rasmusravnandersen/EF_v1p0/Low Pass Eccosorb Filter.pptx

## Low Pass Eccosorb Filter

## Geometries

- Ideal stripline model

- Connectorised stripline on FR4-PCB

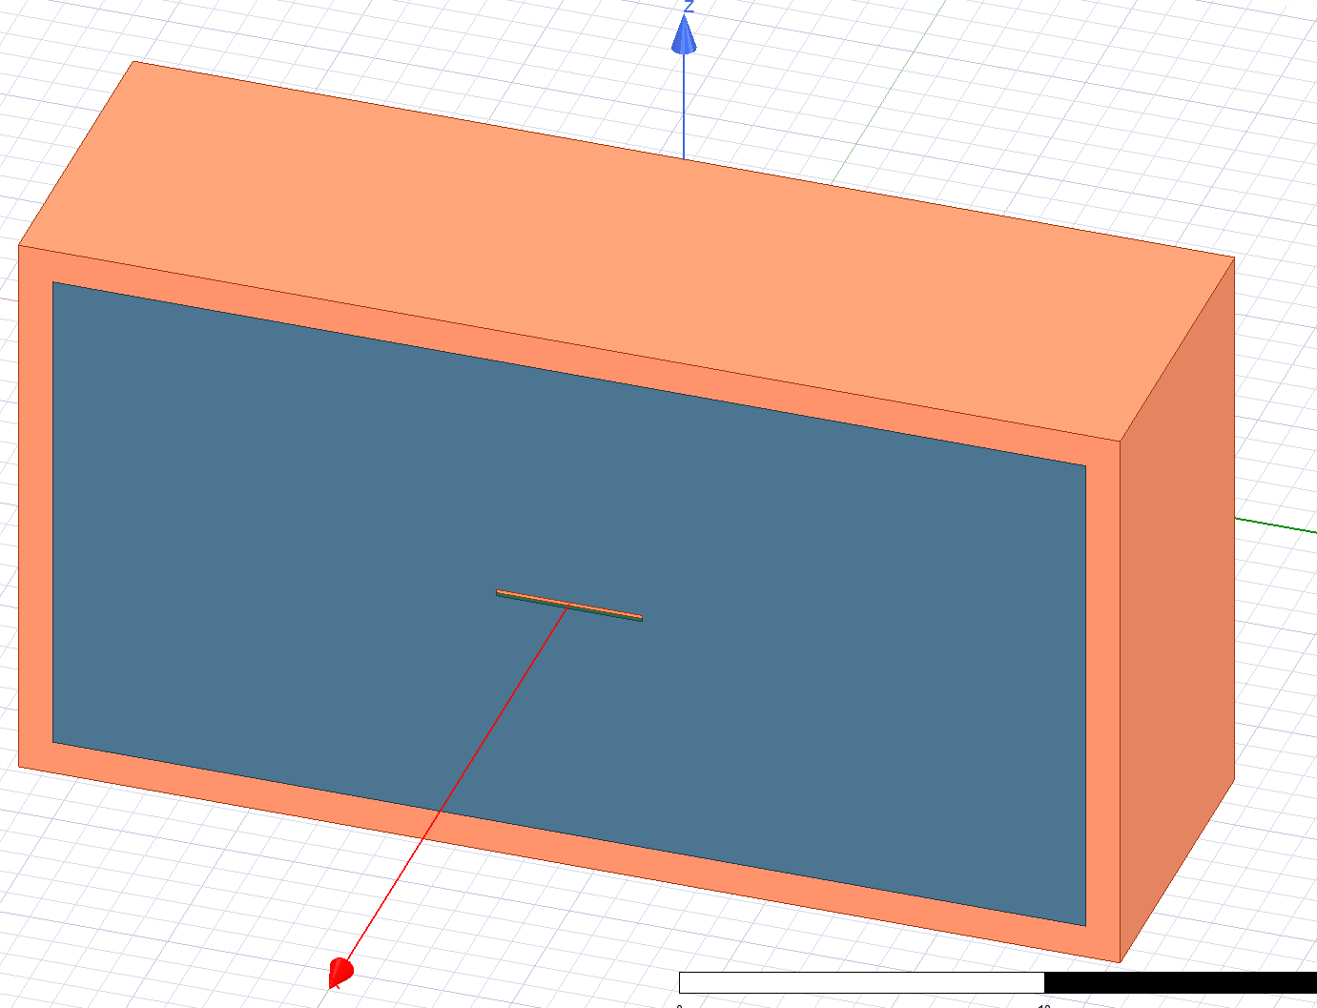
[picture p1: figure]
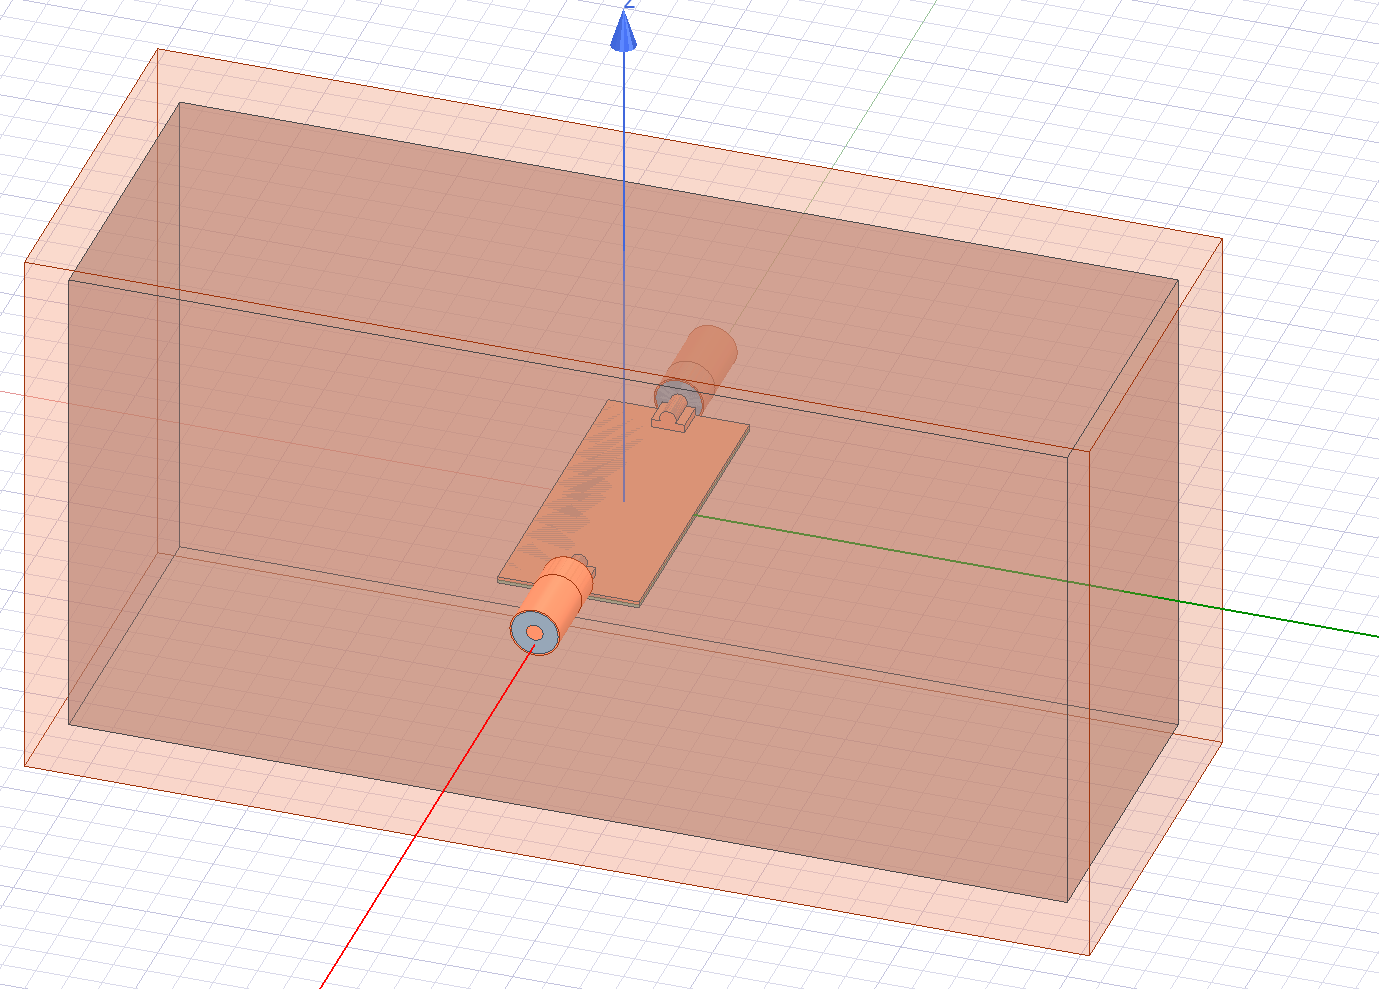
[picture p2: figure]

## Ideal Stripline 2D

- 2D simulations

- Trace width = 4.25 mm Box height = 15 mm, Box width = 30 mm

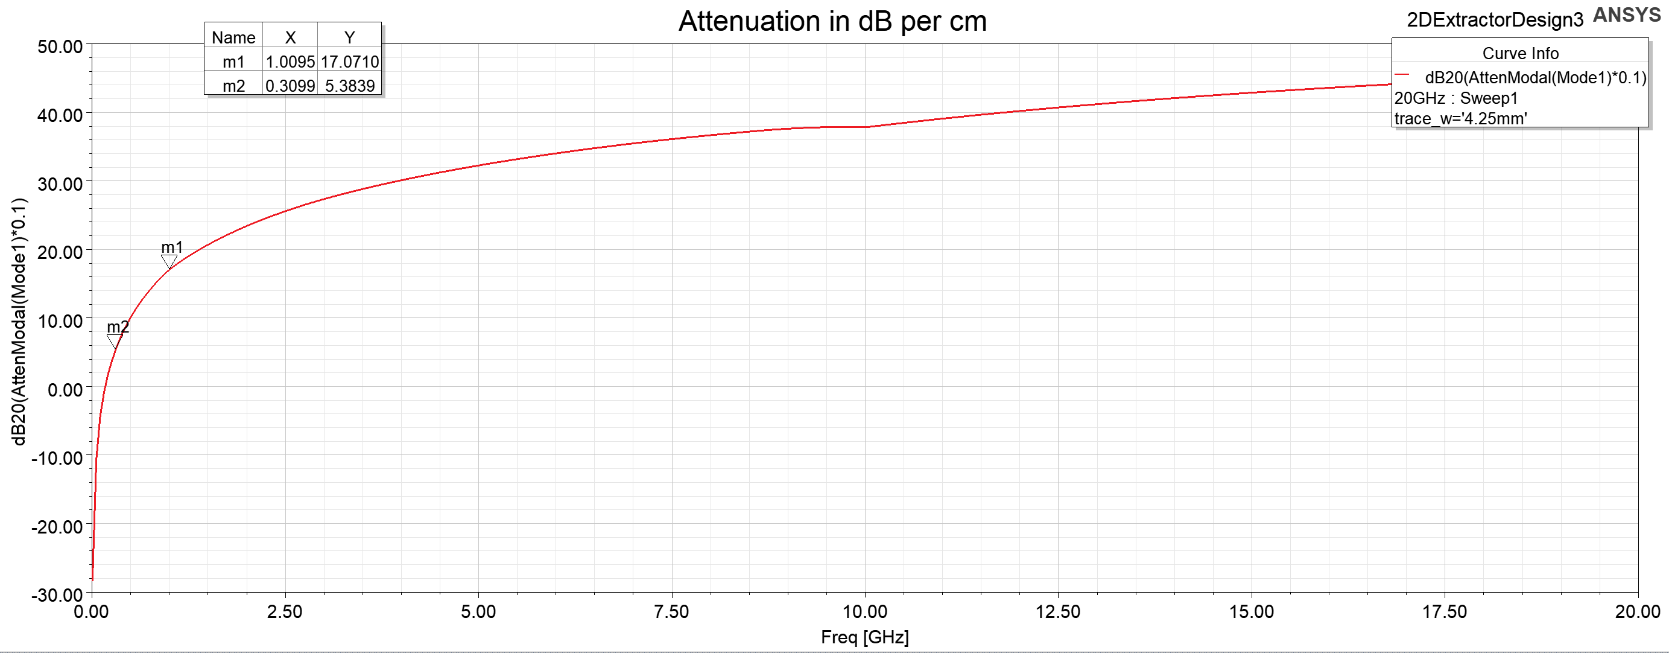
[picture p3: figure]
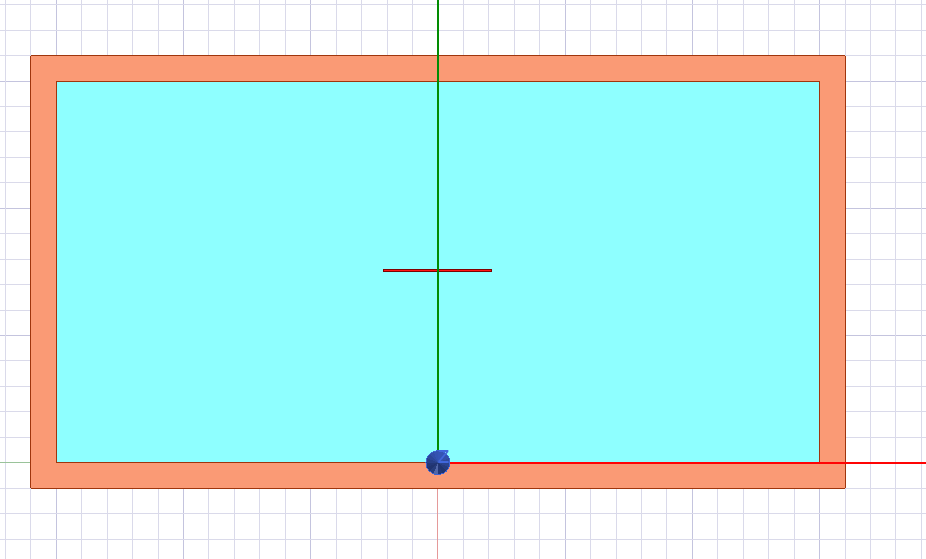
[picture p4: figure]
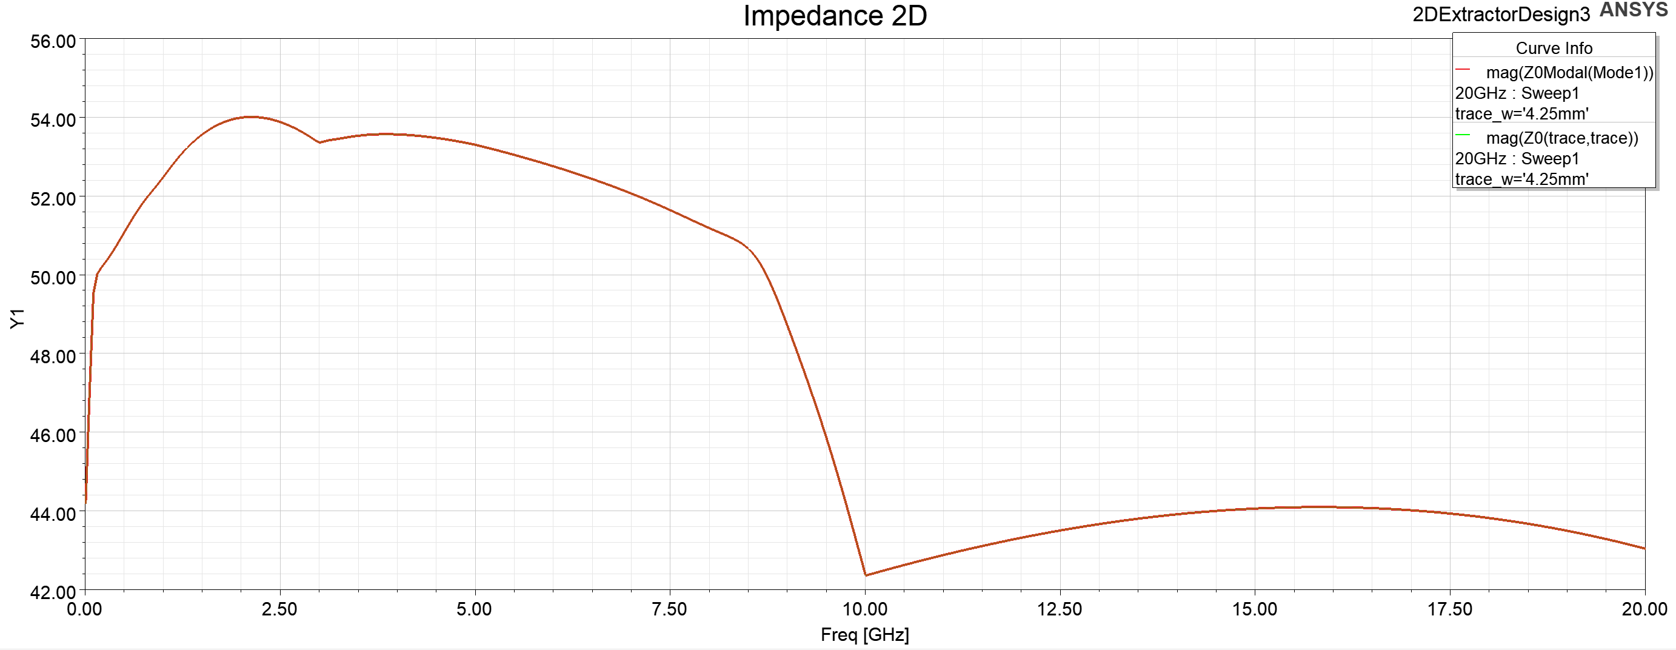
[picture p5: figure]

## Ideal Stripline 3D

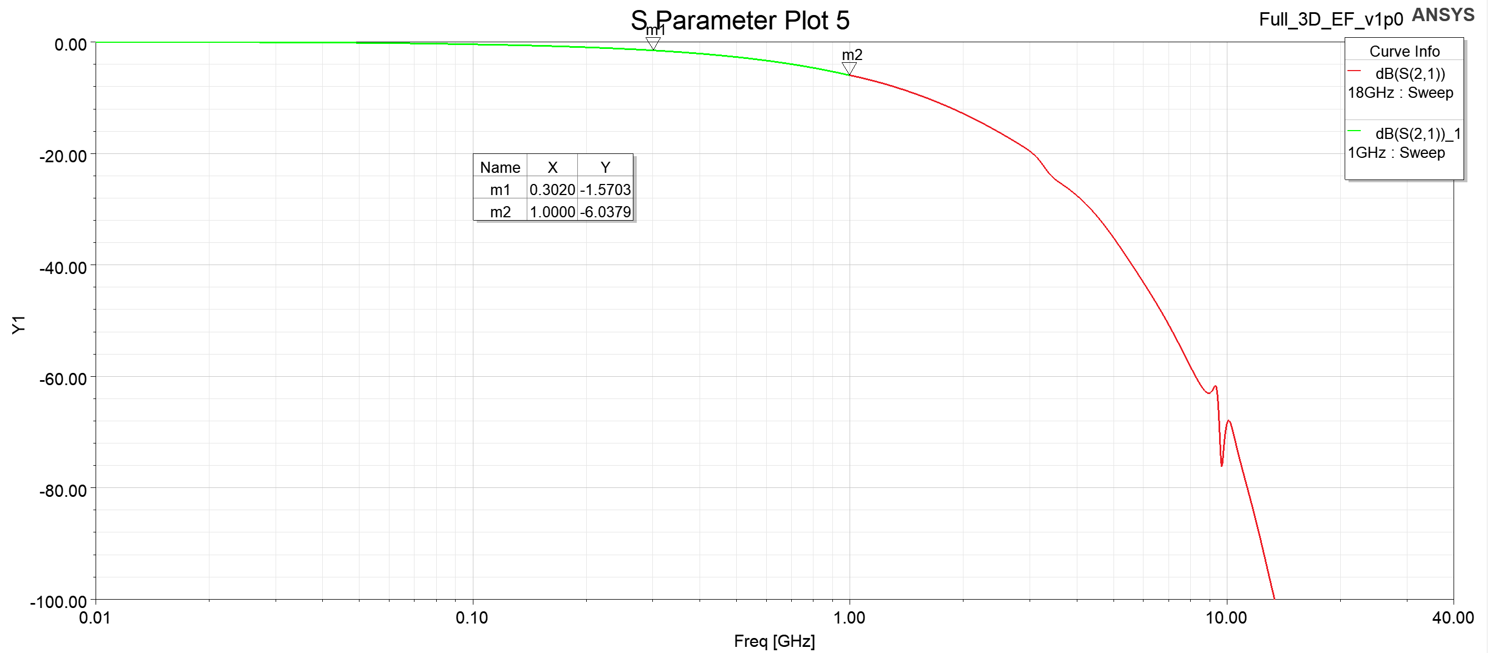
[picture p6: figure]

## Paper comparison

- Impedance-matched low-pass stripline filters by D. F. Santavicca and D. E. Prober

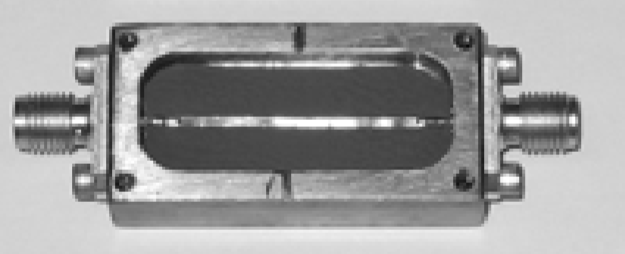
[picture p7: figure]

- Trace width = 1.4 mm Box height = 4.6 mm, Box width = 18 mm

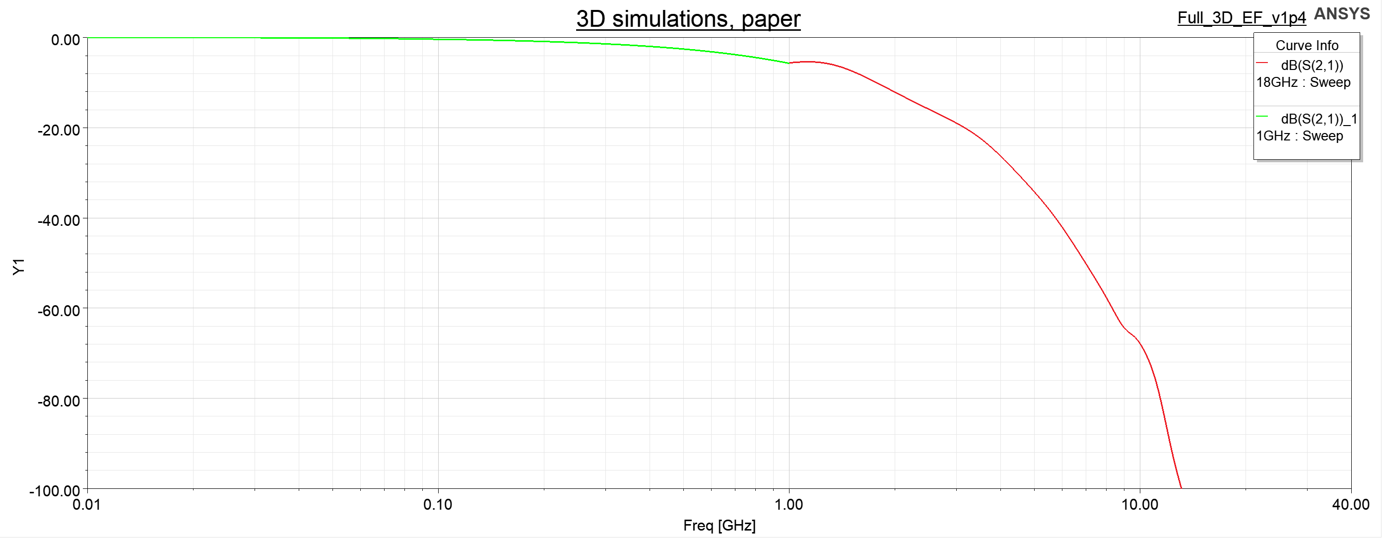
[picture p8: figure]
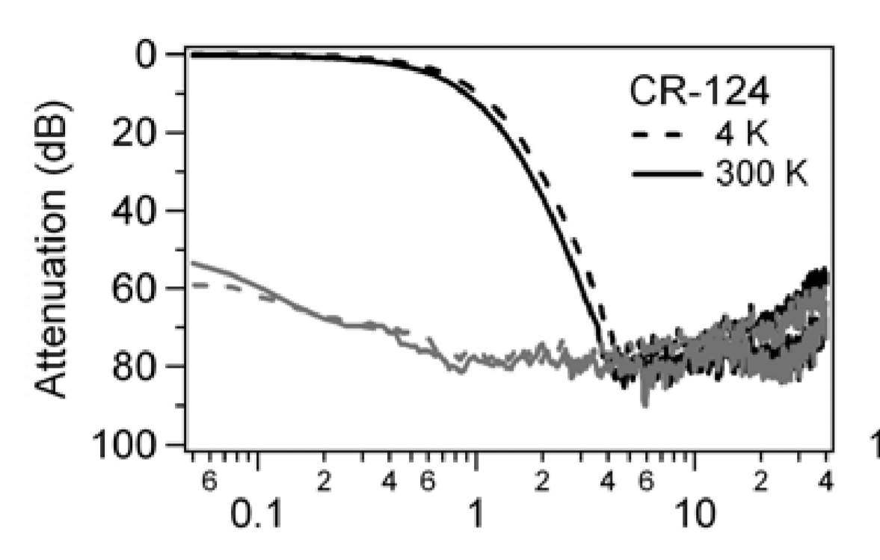
[picture p9: figure]
