rasmusravnandersen/EF_v1p0/EF_v1p0/EF_v1p0_screws.step

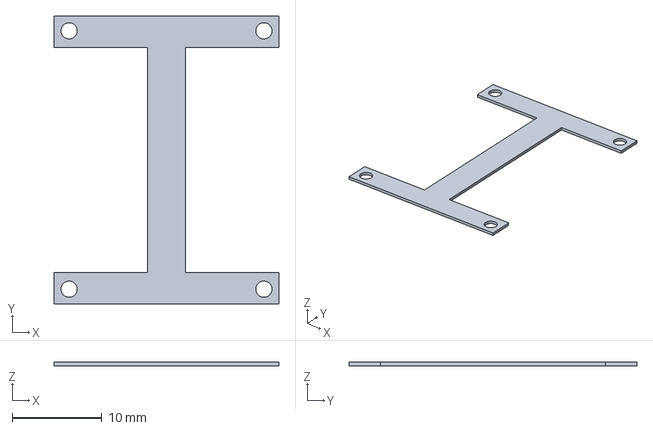
[picture p11: CAD file, 2020-09-11]
EF_v1p0/EF_v1p0_screws.step
25.0 x 32.0 x 0.391 mm
