rasmusravnandersen/EF_v1p0/EF_v1p0/EF_v1p0_noscrews.step

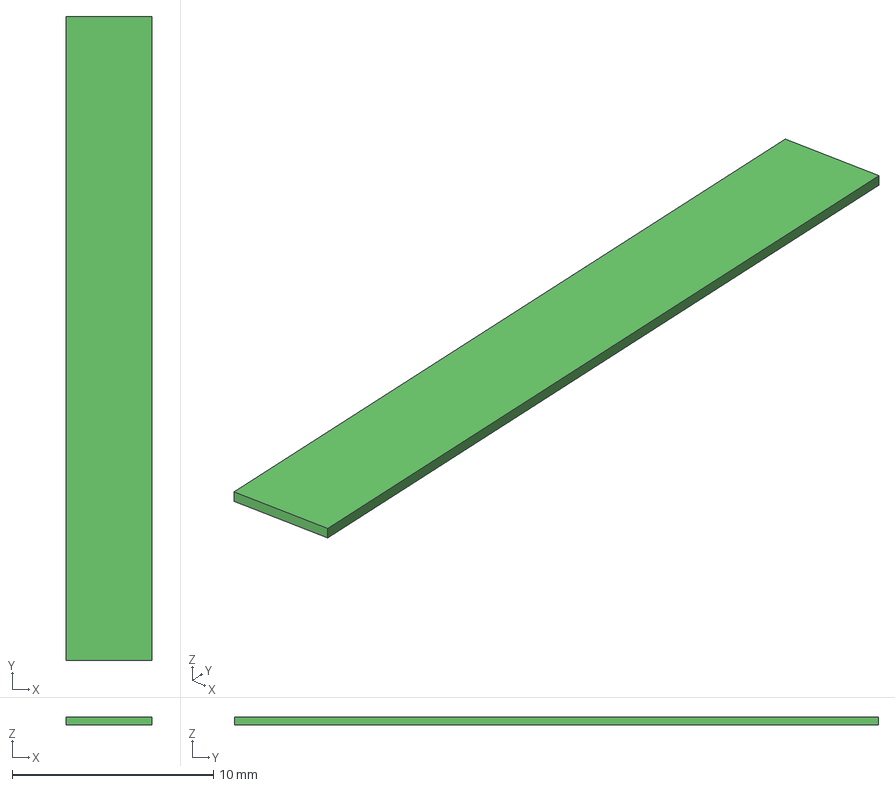
[picture p12: CAD file, 2020-09-11]
EF_v1p0/EF_v1p0_noscrews.step
4.25 x 32.0 x 0.391 mm
