rasmusravnandersen/EF_v1p0/(list of files, drawings)

Other design files:
EF_v1p0/EF_v1p0.PcbDoc
EF_v1p0/EF_v1p0.PrjPcb
EF_v1p1/EF_v1p1.PcbDoc
EF_v1p1/EF_v1p1.PrjPcb
