rasmusravnandersen/EF_v1p0/(commit log)

2020-09-11 first prototype sent for fabrication
    [EF_v1p0.PcbDoc, EF_v1p0.PrjPcb, EF_v1p0_noscrews.step, EF_v1p0_screws.step]
2021-01-22 documentations and clean up
    [6ch_BiasT_V3.stp, EF_v1p1.PcbDoc, EF_v1p1.PrjPcb]
